gunicsba/CAN-Autosteer-Activation/enclosure/CANbuttonPresser.3mf

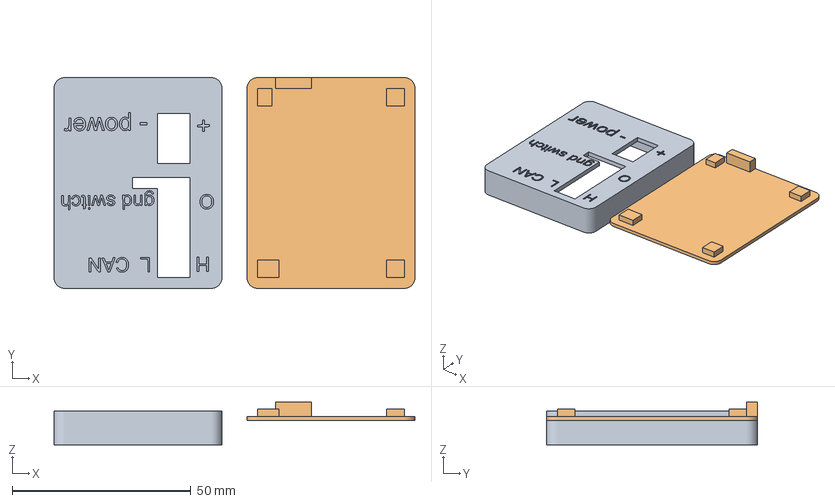
[picture p2: CAD file, 2026-01-26]
enclosure/CANbuttonPresser.3mf
101.0 x 59.0 x 12.0 mm
