gunicsba/CAN-Autosteer-Activation/(list of files, cad)

Other CAD files:
enclosure/CANbuttonPresser.f3d
