gunicsba/CAN-Autosteer-Activation/(list of files, drawings)

Other design files:
PCB/ProPrj_ESP32S3R8N8 CAN Board_2026-01-26.epro
