gunicsba/CAN-Autosteer-Activation/(commit log)

2026-01-26 Initial commit, many more test to come...
    [BOM_LCSC ESP32S3R8N8 Dev Board V1.0.0_PCB_2026-01-26.xlsx, PickAndPlace_PCB_2026-01-26.xlsx, ProPrj_ESP32S3R8N8 CAN Board_2026-01-26.epro]
2026-01-26 add enclosure move ino to the right place to make arduino IDE happy
    [CANbuttonPresser.3mf, CANbuttonPresser.f3d]
